boston-dynamics/bosdyn-hospital-bot/vitals_collection/maskor_gige_cam/README.md

# maskor_gige_cam
ros based driver / tools for FLIR A325sc infrared camera
