boston-dynamics/bosdyn-hospital-bot/20200410-drspot-v1/20200410-drspot-v1-front-pick.JPG

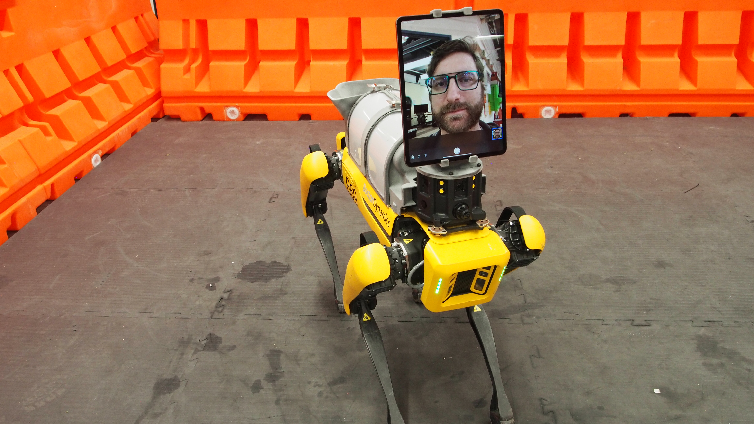
20200410-drspot-v1/20200410-drspot-v1-front-pick.JPG
