boston-dynamics/bosdyn-hospital-bot/02-049531-001-A00 UTM ASSEMBLY/02-049531-001-A00 UTM ASSEMBLY EXPLODED.step

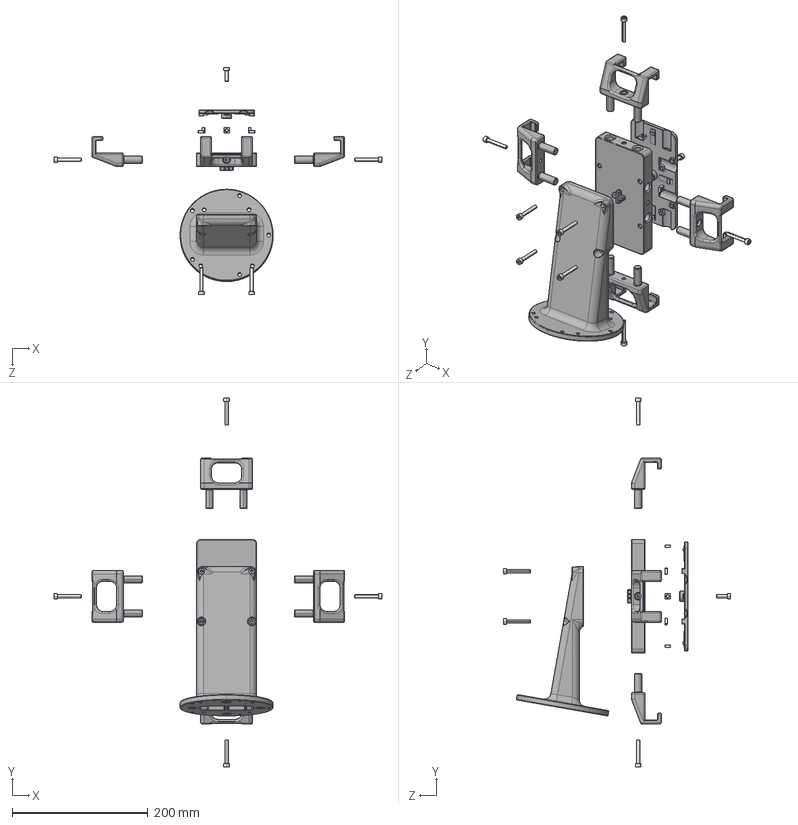
[picture p10: CAD file, 2020-04-09]
02-049531-001-A00 UTM ASSEMBLY/02-049531-001-A00 UTM ASSEMBLY EXPLODED.step
482.2 x 542.8 x 334.7 mm
02-049419-004_old
ISO 4762 M5 x 35 --- 22C_ISO 4762 M5 x 35 --- 22C x 8
ISO 4762 M5 x 16 --- 16C_ISO 4762 M5 x 16 --- 16C
02-049530-001_90225A101 x 8
