boston-dynamics/bosdyn-hospital-bot/02-049412-001-A00 DECON GUARD/02-049405-003-A02 DECON GUARD PANEL A.STL

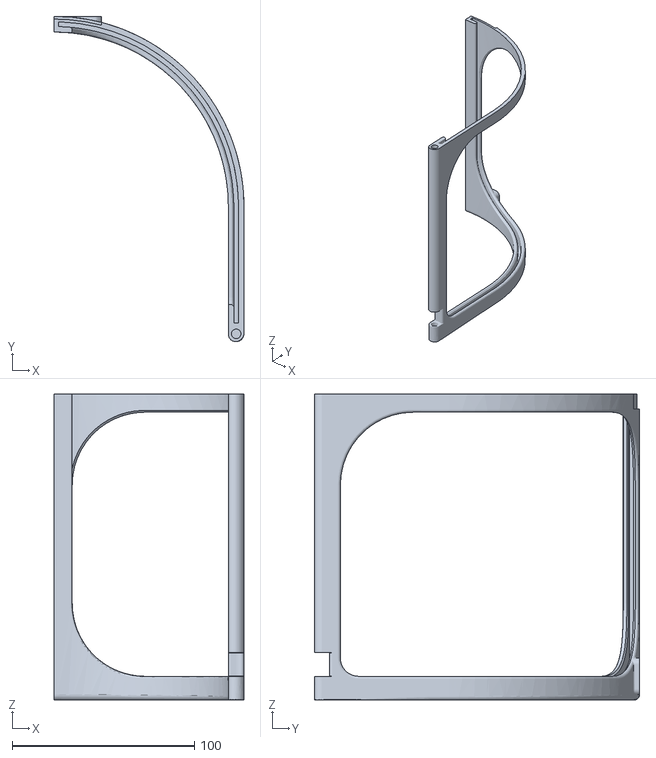
[picture p11: CAD file, 2020-04-09]
02-049412-001-A00 DECON GUARD/02-049405-003-A02 DECON GUARD PANEL A.STL
104.3 x 178.6 x 168.0
