boston-dynamics/bosdyn-hospital-bot/02-049531-001-A00 UTM ASSEMBLY/02-049419-002-A03 UTM BASE.STL

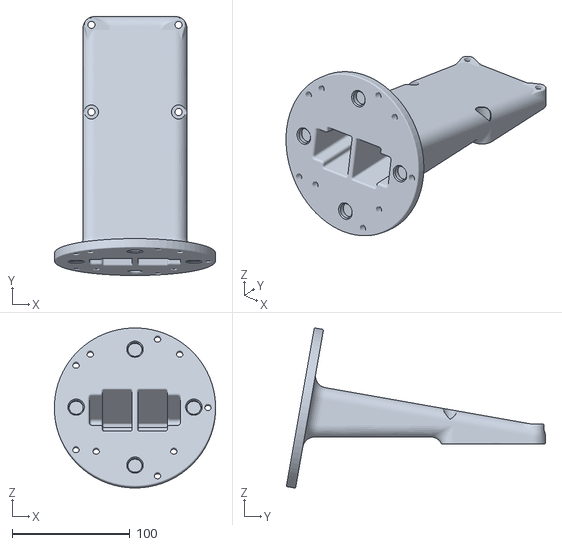
[picture p12: CAD file, 2020-04-09]
02-049531-001-A00 UTM ASSEMBLY/02-049419-002-A03 UTM BASE.STL
137.0 x 220.0 x 135.9
