boston-dynamics/bosdyn-hospital-bot/02-049412-001-A00 DECON GUARD/02-049405-005-A02 DECON GUARD REAR.STL

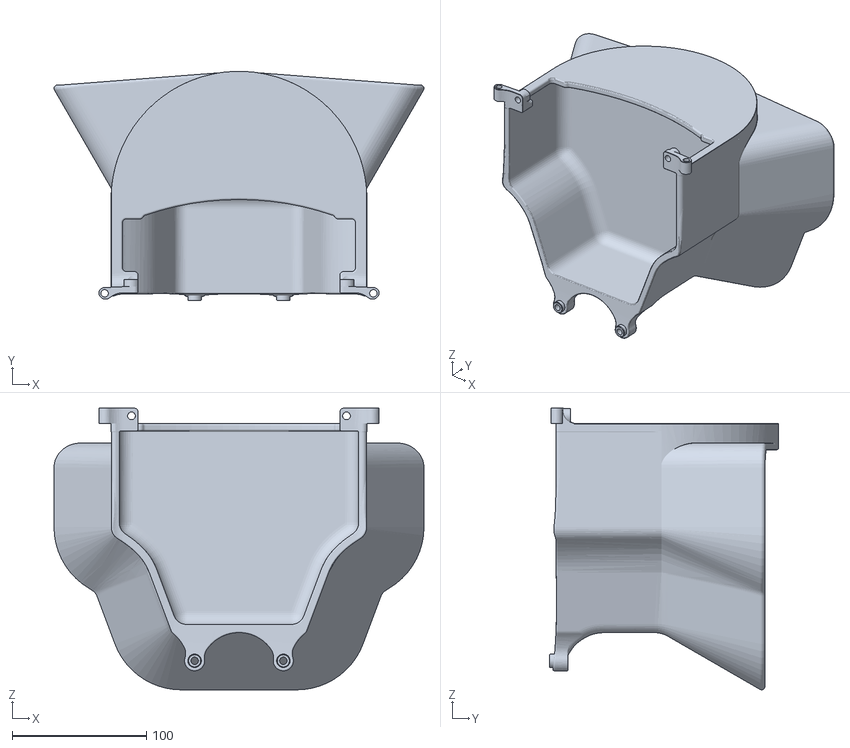
[picture p13: CAD file, 2020-04-09]
02-049412-001-A00 DECON GUARD/02-049405-005-A02 DECON GUARD REAR.STL
275.3 x 170.7 x 209.6
