boston-dynamics/bosdyn-hospital-bot/02-049412-001-A00 DECON GUARD/02-049405-007-A02 DECON GUARD SPAR.STL

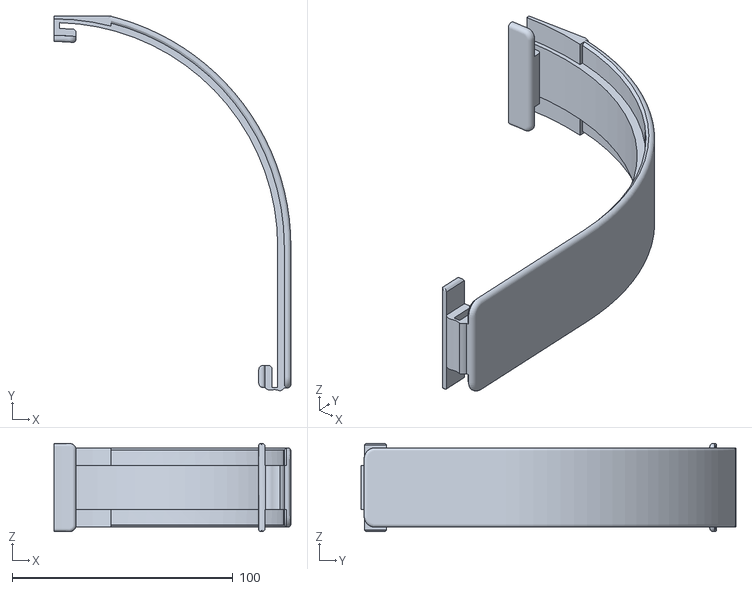
[picture p14: CAD file, 2020-04-09]
02-049412-001-A00 DECON GUARD/02-049405-007-A02 DECON GUARD SPAR.STL
107.3 x 169.9 x 40.0
