boston-dynamics/bosdyn-hospital-bot/02-049531-001-A00 UTM ASSEMBLY/02-049419-006-A03 UTM HUB COVER.STL

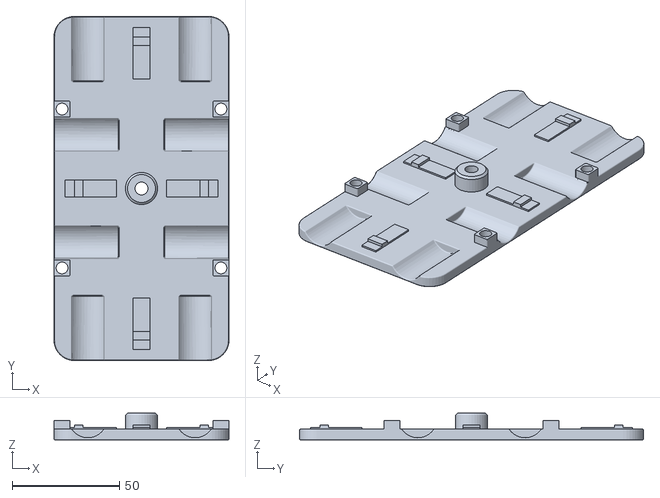
[picture p15: CAD file, 2020-04-09]
02-049531-001-A00 UTM ASSEMBLY/02-049419-006-A03 UTM HUB COVER.STL
81.5 x 160.2 x 12.5
