boston-dynamics/bosdyn-hospital-bot/02-049531-001-A00 UTM ASSEMBLY/02-049419-003-A04 UTM ARM.STL

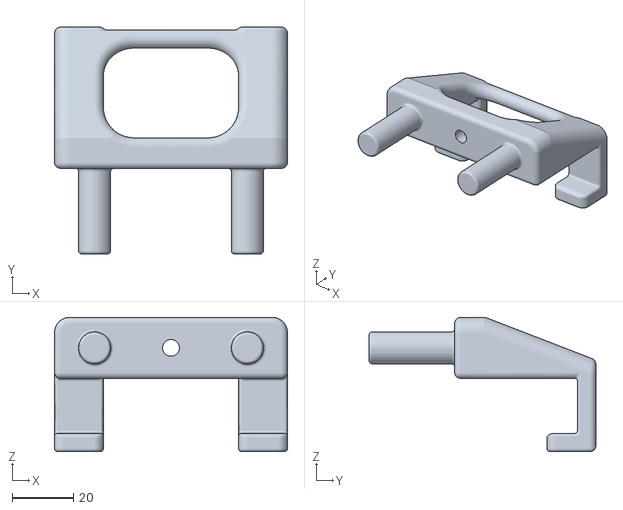
[picture p16: CAD file, 2020-04-09]
02-049531-001-A00 UTM ASSEMBLY/02-049419-003-A04 UTM ARM.STL
76.3 x 74.2 x 44.0
