boston-dynamics/bosdyn-hospital-bot/02-049412-001-A00 DECON GUARD/02-049405-006-A02 DECON GUARD HDPE SHEET.STL

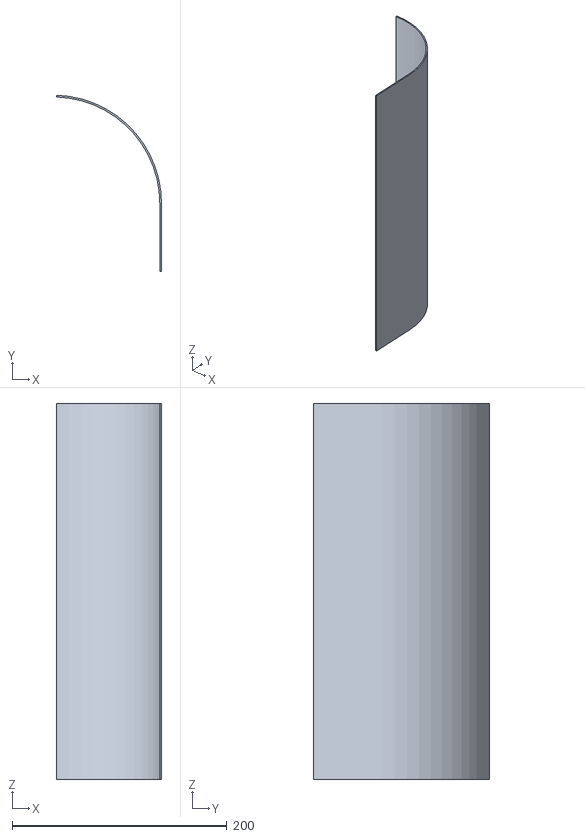
[picture p17: CAD file, 2020-04-09]
02-049412-001-A00 DECON GUARD/02-049405-006-A02 DECON GUARD HDPE SHEET.STL
97.8 x 164.2 x 350.0
