boston-dynamics/bosdyn-hospital-bot/02-049412-001-A00 DECON GUARD/02-049405-004-A02 DECON GUARD FRONT.STL

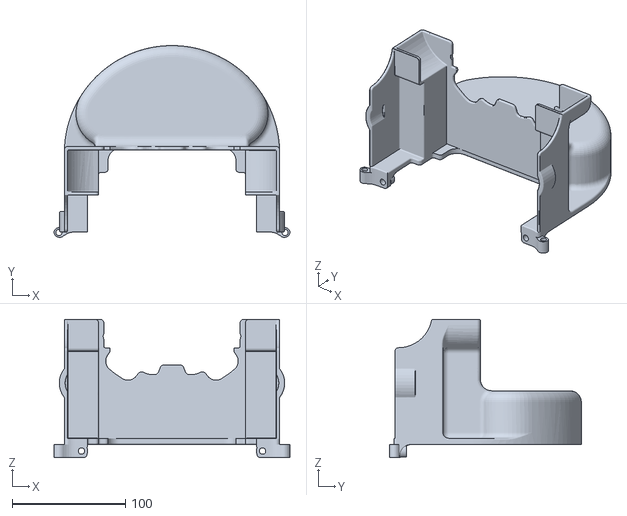
[picture p18: CAD file, 2020-04-09]
02-049412-001-A00 DECON GUARD/02-049405-004-A02 DECON GUARD FRONT.STL
208.6 x 169.6 x 122.0
