boston-dynamics/bosdyn-hospital-bot/02-049531-001-A00 UTM ASSEMBLY/02-049419-004-A04 UTM HUB.STL

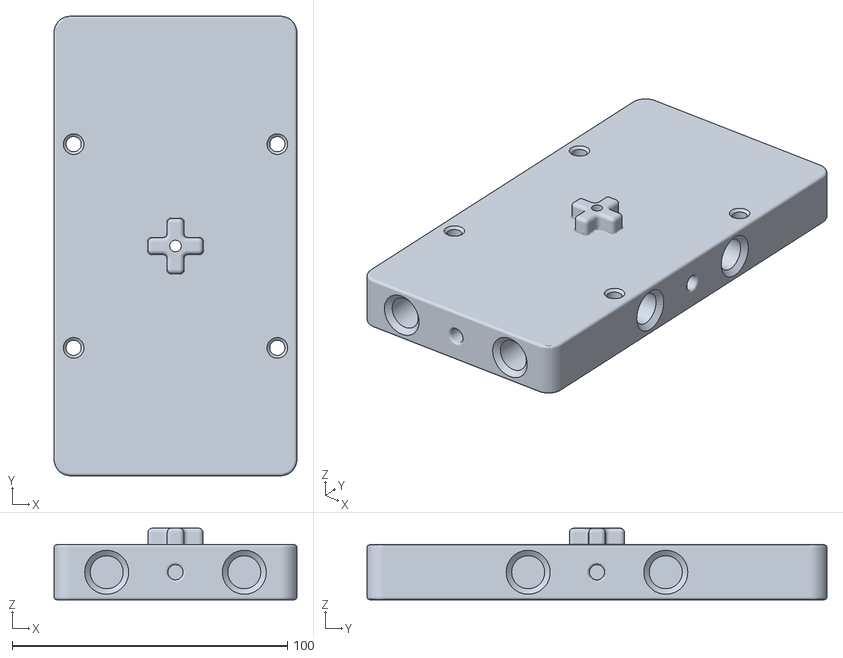
[picture p19: CAD file, 2020-04-09]
02-049531-001-A00 UTM ASSEMBLY/02-049419-004-A04 UTM HUB.STL
88.3 x 167.0 x 26.0
