boston-dynamics/bosdyn-hospital-bot/02-049412-001-A00 DECON GUARD/02-049405-008-A02 DECON GUARD HINGE.STL

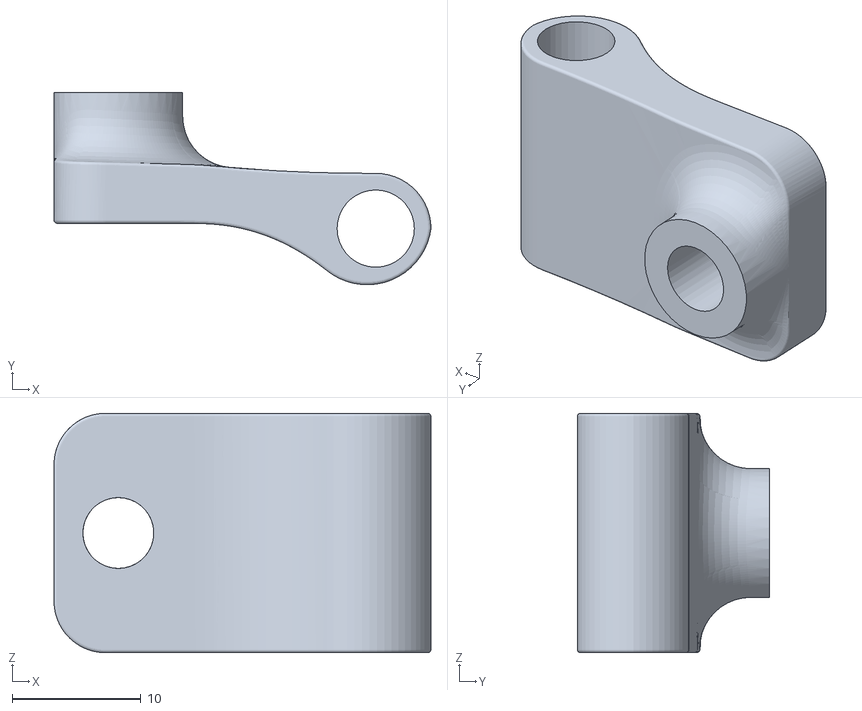
[picture p20: CAD file, 2020-04-09]
02-049412-001-A00 DECON GUARD/02-049405-008-A02 DECON GUARD HINGE.STL
29.3 x 15.0 x 18.6
