boston-dynamics/bosdyn-hospital-bot/(list of files, cad)

Other CAD files:
02-049412-001-A00 DECON GUARD/02-049405-002-A02 DECON GUARD PANEL B.STL
