boston-dynamics/bosdyn-hospital-bot/(commit log)

2020-04-09 Initial solid models for Spot healthcare payloads
    Tablet mount, decontamination guard, and basket.
    [02-049405-002-A02 DECON GUARD PANEL B.STL, 02-049405-003-A02 DECON GUARD PANEL A.STL, 02-049405-004-A02 DECON GUARD FRONT.STL, 02-049405-005-A02 DECON GUARD REAR.STL, 02-049405-006-A02 DECON GUARD HDPE SHEET.STL, 02-049405-007-A02 DECON GUARD SPAR.STL, 02-049405-008-A02 DECON GUARD HINGE.STL, 02-049419-002-A03 UTM BASE.STL]
2020-04-10 Dr. Spot v1 images
    Photos of prototype at BD.
2020-04-15 [DrSpot] Add vitals sign detection for respiratory rate and skin temperature
    [Flir.cfg, Threshold.cfg]
2020-04-16 [DrSpot] Track ROIs in between face detection updates
2020-04-17 [DrSpot] Move vitals code into subfolder
    [Flir.cfg, Threshold.cfg]
2020-04-18 [DrSpot] Threading and robustness fixes
2020-04-18 [DrSpot] Switch back to mean
2020-04-21 [DrSpot] Launch multichrome camera array
2020-04-21 [DrSpot] Add spinnaker driver for mono array
    [spinnaker_cam.cfg]
2020-04-21 [DrSpot] increase dynamic reconfigure max exposure
    [spinnaker_cam.cfg]
2020-04-22 [DrSpot] Remove mask temperature calculator
2020-04-23 [DrSpot] Add image_view2 to manually specify ROIs
    [ImageView2.cfg]
2020-04-23 [DrSpot] Fix optris temperature conversion; add to readmes
2020-04-24 [DrSpot] Cut out unnecessary logged topics
2020-04-24 [DrSpot] Track optional git hook for bare repo for pushing into SpotCORE
2020-04-27 [DrSpot] Do the heart rate calculation in a thread
2020-04-30 [DrSpot] No need to track GRAY2RGB versions of images. Mean-normalize resp rate data
2020-04-30 [DrSpot] Track forehead in every frame in HR node
2020-05-01 [DrSpot] Make easy to switch heart rate from forehead to carotid
2020-05-04 [DrSpot] Add spreadsheet for blood volume pulse method
    [pulse_signature_vector.xlsx]
2020-05-04 [DrSpot] Add all illumination sources and 100% SpO2 PPG spectrum
    [pulse_signature_vector.xlsx]
2020-05-04 [DrSpot] Add rest of SpO2 PPG spectra
    [pulse_signature_vector.xlsx]
2020-05-04 [DrSpot] Complete PBV calculation for monochrome array
    [pulse_signature_vector.xlsx]
2020-05-04 [DrSpot] Complete PBV calculation for RGB chameleon
    [pulse_signature_vector.xlsx]
2020-05-05 [DrSpot] Photometrically align the first frame of all three color channels
2020-05-05 [DrSpot] Add per-camera gain setting
    [spinnaker_cam.cfg]
2020-05-11 [DrSpot] Add thermal reference code and configure to use
    [pulse_signature_vector.xlsx]
2020-05-11 [DrSpot] Keep FLIR driver from grabbing USB chameleons
2020-05-12 Fixing issue where thermal reference heater does not shutdown
2020-05-14 [DrSpot] 2-stage tracking in heart_rate node; increase computation time in mode manager
2020-05-14 [DrSpot] Don't grab spinnaker frames if disabled
2020-05-14 [DrSpot] Fix locking in multichrome enable / disable
    [acquisition_node.cpp, capture.cpp]
2020-05-14 [DrSpot] fix flir camera stream enable service name
2020-05-15 [DrSpot] Add config for synced multichrome cameras; disabled by default
2020-05-15 [DrSpot] Reinit fine template matcher on every frame
2020-05-15 [DrSpot] Add raw frame measurement in skin temp node
2020-05-18 [DrSpot] Add rate div param to spinnaker camera driver
